acornelissen/RhodiumOS/(commit log)

2025-03-03 Sorted out the diopter calcs, finally, correctly. Hopefully.
    [constants.h, helpers.h, interface.h, setfuncs.h]
2025-03-03 Add a way to reset all setttings to default.
    [helpers.h, inputs.h]
2025-03-03 remove extra bracket
2025-03-04 Removing diopter logic until I can figure out how best to implement it.
    The big reason is that it seems for each close-up lens, because the effective focal length of the lens changes, the distance calculation needs to be adjusted, as well as the LiDAR offset.
2025-03-04 Add STEP and PCB files as well, organise things a bit.
    [MRF67-pro-small-B_Cu.gbr, MRF67-pro-small-B_Mask.gbr, MRF67-pro-small-B_Paste.gbr, MRF67-pro-small-B_Silkscreen.gbr, MRF67-pro-small-Edge_Cuts.gbr, MRF67-pro-small-F_Cu.gbr, MRF67-pro-small-F_Mask.gbr, MRF67-pro-small-F_Paste.gbr]
